martinclausen2/Nachttischlampe/mechanics/Beschreibung Mechanik LED Leuchte V2.odt

Beschreibung Mechanik Projekt LED Leuchte V2

Martin Clausen, Stand 2014-03-09

Übersicht zu bearbeitender mechanischer Bauteile für ein Pärchen (2 Stück).

Bauteil | Material | Bemerkung | Asymmetrie rechts/links | Anzahl
Arm | Item, 0.0.492.88, 480mm | | Orientierung zwischen Taschen und Ausfräsung | von 2 Varianten je ein Stück
Gelenk | Item, 0.0.601.13 | | Orientierung Bohrung | von 2 Varianten je ein Stück
beweglicher Arm | Item, 0.0.492.88, 160mm | | keine | 2 Stück
Fuß | Item, 0.0.493.04, 160mm | Gewindebohrungen im Raster 90mm x 21mm aus der Mitte verschoben angeordnet! | Orientierung der M8-Innengewinde | von 2 Varianten je ein Stück
Frontplatte | Aluminium-Blech, eloxiert natur | Stärke des Bleches kann 2mm oder 2,5mm sein | keine | 2 Stück
Kappe 40x80 | Item, 0.0.489.61 | | keine | 2 Stück
Kappe 80x80 | Item, 0.0.489.98 | | keine | 2 Stück

Alle Bauteile frei von Kratzern und Spänen, Aluminium makellos eloxiert (natur)
