martinclausen2/Nachttischlampe/mechanics/Lampe links.FCStd

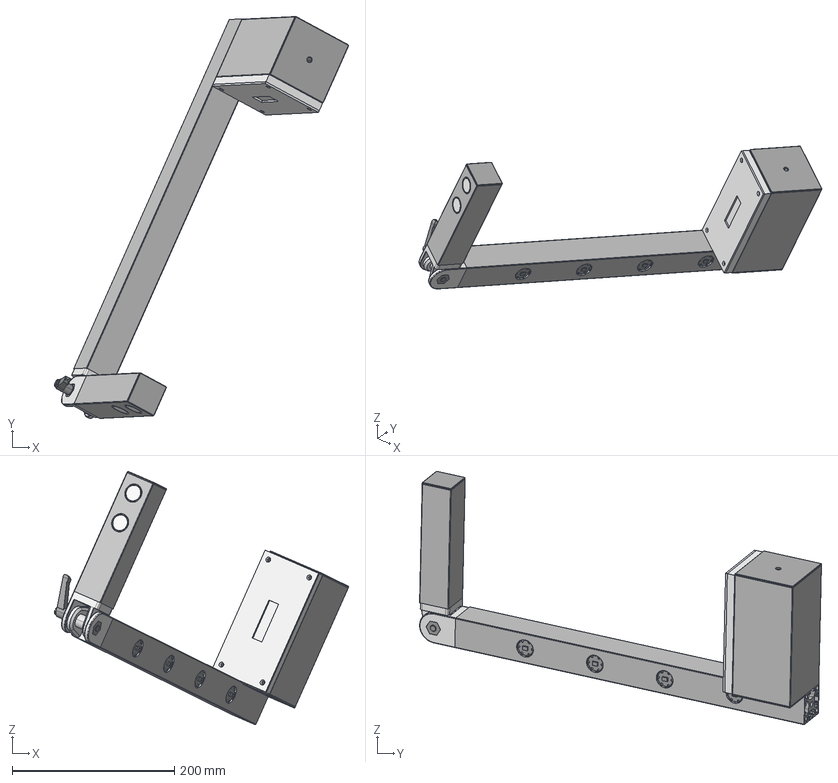
[picture p1: CAD file, 2016-03-12]
mechanics/Lampe links.FCStd
362.3 x 494.8 x 311.9 mm
Fuss links
Arm links
Kappe80x80
Kappe80x40
0.0.601.13_4 links
0.0.601.13_5 links
beweglicher_Arm
Kappe40x40
LED-Star
LED-Star001
LED-Star002
LED-Star003
LED-Star004
LED-Star005
LED Spacer
LED Spacer001
LED Spacer002
LED Spacer003
Linse
Linse001
Frontplattenspacer
Frontplatte
pcb
