martinclausen2/Nachttischlampe/mechanics/Lampe.FCStd

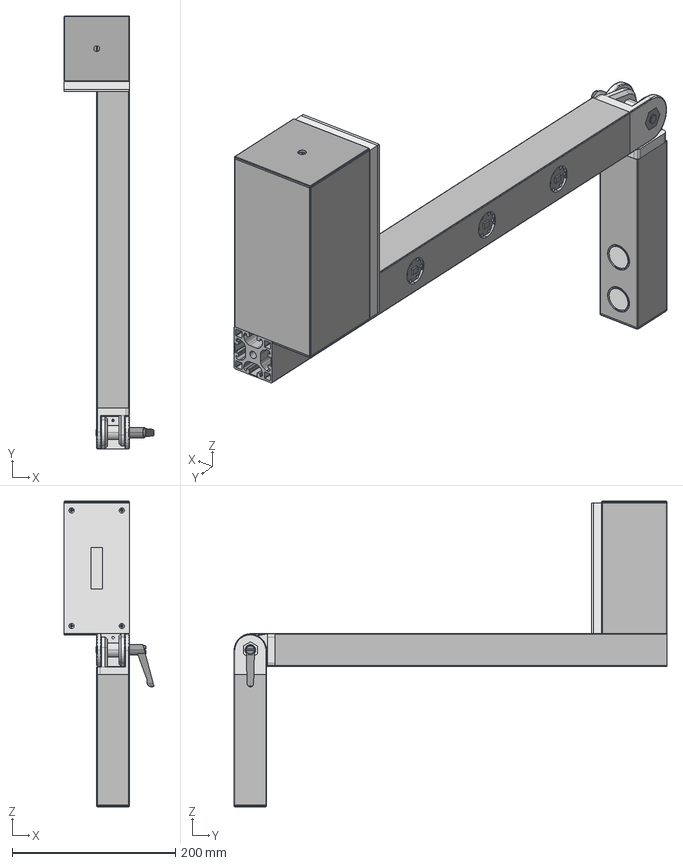
[picture p2: CAD file, 2016-03-12]
mechanics/Lampe.FCStd
110.1 x 530.0 x 374.0 mm
Fuss
Arm
Kappe80x80
Kappe80x40
beweglicher_Arm
Kappe40x40
LED-Star
LED-Star001
LED-Star002
LED-Star003
LED-Star004
LED-Star005
LED Spacer
LED Spacer001
LED Spacer002
LED Spacer003
Linse
Linse001
Frontplattenspacer
Frontplatte
pcb
