martinclausen2/Nachttischlampe/schematics/LED-Lampe Power  ZXLD1374.brd

## EAGLE design schematics/LED-Lampe Power ZXLD1374.brd

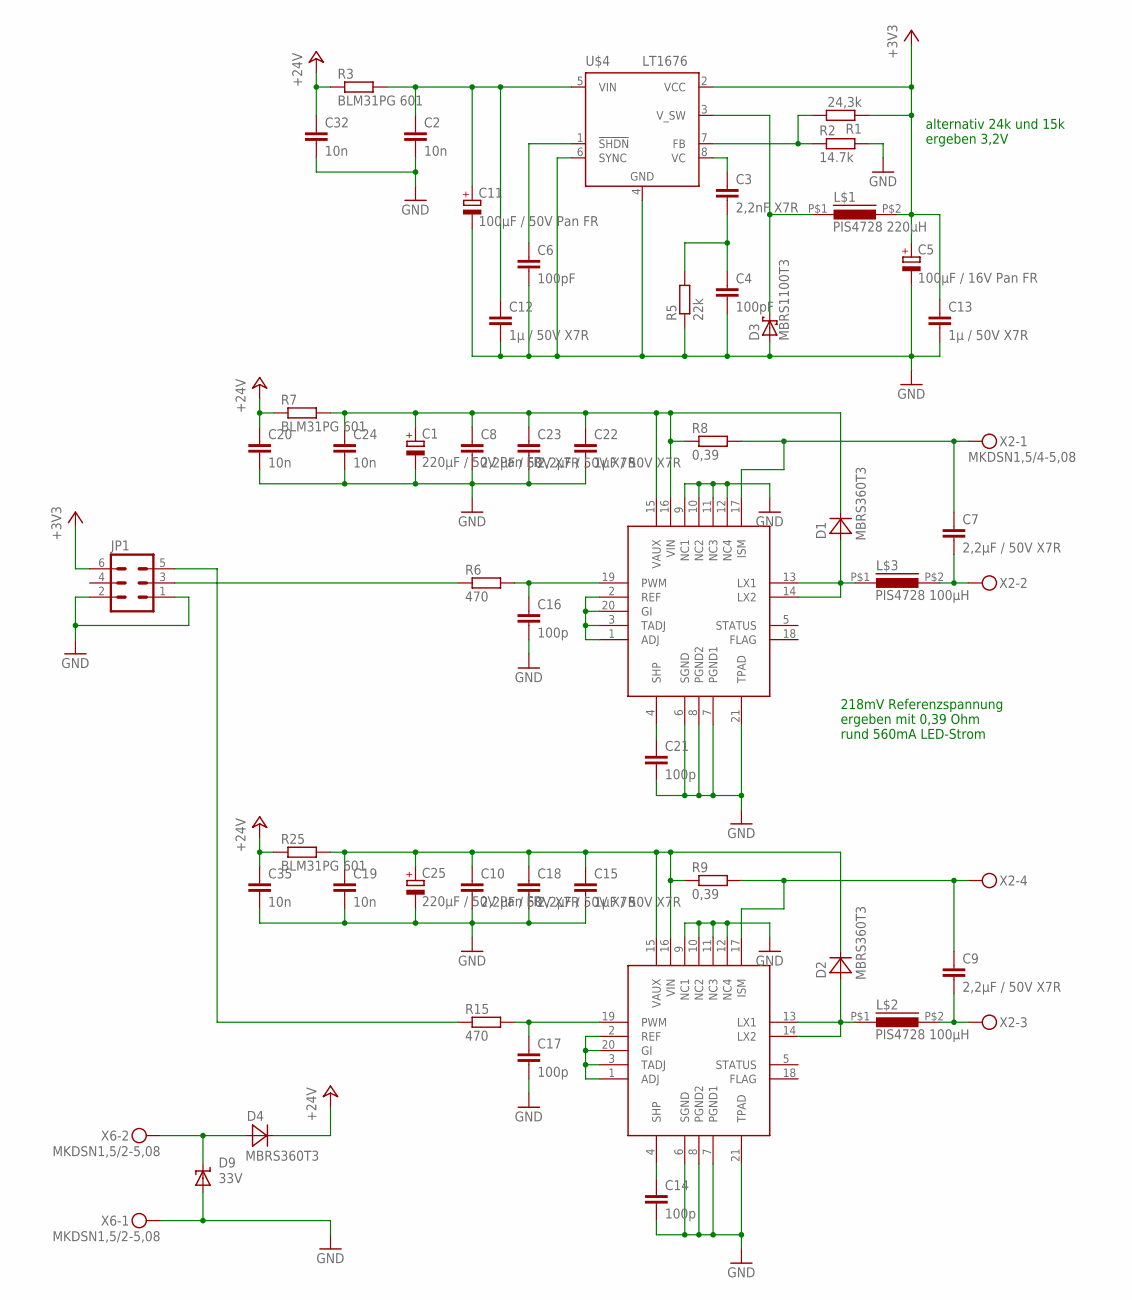
[picture p3: schematic LED-Lampe Power ZXLD1374.sch]

Parts:
C1, C25: 220µF / 50V Pan FR; E5-10,5
C2, C19, C20, C24, C32, C35: 10n; C0805
C3: 2,2nF X7R; C0603
C4, C6: 100pF; C0603
C5: 100µF / 16V Pan FR; E2-5
C7, C8, C9, C10, C18, C23: 2,2µF / 50V X7R; C1206
C11: 100µF / 50V Pan FR; E3,5-8
C12, C13: 1µ / 50V X7R; C1206
C14, C16, C17, C21: 100p; C0603
C15, C22: 1µF / 50V X7R; C1206
D1, D2, D4: MBRS360T3; SMC
D3: MBRS1100T3; SMB
D9: 33V; SMBJ
JP1: ML6
L$1: PIS4728 220µH; FASTON_PIS4728
L$2, L$3: PIS4728 100µH; FASTON_PIS4728
R1: 24,3k; R1206
R2: 14.7k; R1206
R3, R7, R25: BLM31PG 601; R1206
R5: 22k; R1206
R6, R15: 470; R0805
R8, R9: 0,39; R1206
U$4: LT1676; S8
U$5, U$6: ZXLD1374; TSSOP20
X2: MKDSN1,5/4-5,08
X6: MKDSN1,5/2-5,08

Connections:
+3V3: C5.+, C13.1, JP1.6, L$1.P$2 (2), R1.1, U$4.2 (VCC)
+24V: C20.1, C32.1, C35.1, D4.C, R3.1, R7.1, R25.1
GND: C1.-, C2.2, C4.2, C5.-, C6.2, C8.2, C10.2, C11.-, C12.2, C13.2, C14.2, C15.2, C16.2, C17.2, C18.2, C19.2, C20.2, C21.2, C22.2, C23.2, C24.2, C25.-, C32.2, C35.2, D3.A, D9.A, JP1.1, JP1.2, R2.2, R5.1, U$4.4 (GND), U$4.6 (SYNC), U$5.6 (SGND), U$5.7 (PGND1), U$5.8 (PGND2), U$5.9 (NC1), U$5.10 (NC2), U$5.11 (NC3), U$5.12 (NC4), U$5.21 (TPAD), U$6.6 (SGND), U$6.7 (PGND1), U$6.8 (PGND2), U$6.9 (NC1), U$6.10 (NC2), U$6.11 (NC3), U$6.12 (NC4), U$6.21 (TPAD), X6.1
unnamed: C2.1, C11.+, C12.1, R3.2, U$4.5 (VIN)
unnamed: U$5.1 (ADJ), U$5.2 (REF), U$5.3 (TADJ), U$5.20 (GI)
unnamed: C3.2, C4.1, R5.2
unnamed: R1.2, R2.1, U$4.7 (FB)
unnamed: D3.C, L$1.P$1 (1), U$4.3 (V_SW)
unnamed: JP1.3, R6.1
unnamed: C1.+, C8.1, C22.1, C23.1, C24.1, D1.C, R7.2, R8.1, U$6.15 (VAUX), U$6.16 (VIN)
unnamed: D4.A, D9.C, X6.2
unnamed: C3.1, U$4.8 (VC)
unnamed: C9.2, L$2.P$2 (2), X2.3
unnamed: C17.1, R15.2, U$5.19 (PWM)
unnamed: C6.1, U$4.1 (!SHDN)
unnamed: C9.1, R9.2, U$5.17 (ISM), X2.4
unnamed: C14.1, U$5.4 (SHP)
unnamed: D2.A, L$2.P$1 (1), U$5.13 (LX1), U$5.14 (LX2)
unnamed: C16.1, R6.2, U$6.19 (PWM)
unnamed: C7.2, L$3.P$2 (2), X2.2
unnamed: C7.1, R8.2, U$6.17 (ISM), X2.1
unnamed: U$6.1 (ADJ), U$6.2 (REF), U$6.3 (TADJ), U$6.20 (GI)
unnamed: C21.1, U$6.4 (SHP)
unnamed: D1.A, L$3.P$1 (1), U$6.13 (LX1), U$6.14 (LX2)
unnamed: C10.1, C15.1, C18.1, C19.1, C25.+, D2.C, R9.1, R25.2, U$5.15 (VAUX), U$5.16 (VIN)
P1.6: JP1.5, R15.1

Notes on the sheet:
218mV Referenzspannung ergeben mit 0,39 Ohm rund 560mA LED-Strom
alternativ 24k und 15k ergeben 3,2V

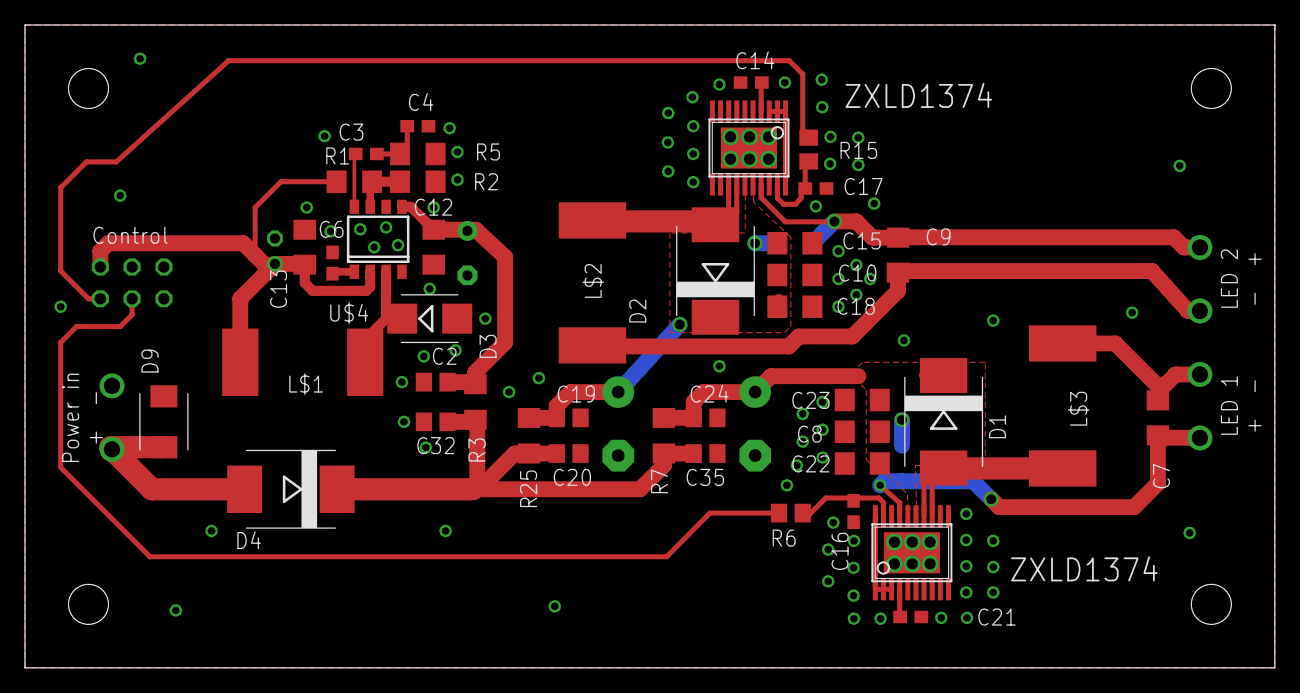
[picture p4: board LED-Lampe Power ZXLD1374.brd from above]

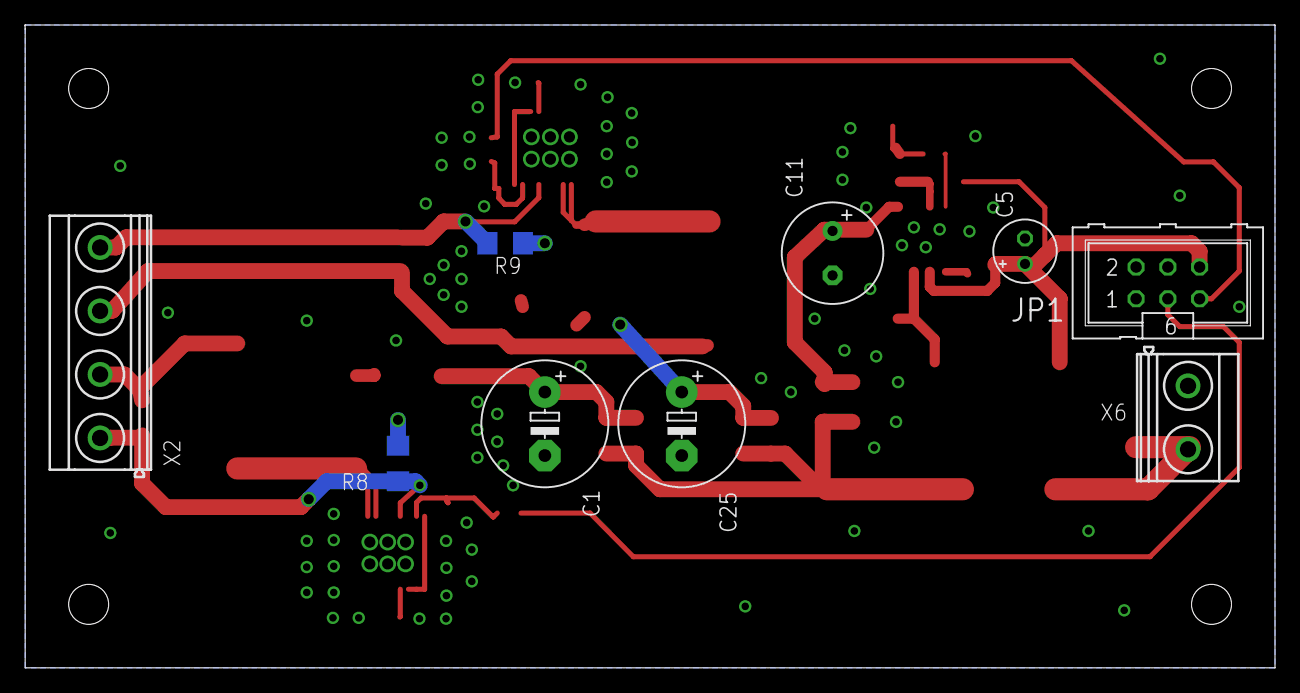
[picture p5: board LED-Lampe Power ZXLD1374.brd from below]

Board: 2 copper layers, 100.0 x 51.4 mm, 51 parts (9 on the bottom side), 26 nets.
