martinclausen2/Nachttischlampe/schematics/LED-Lampe MCU.brd

## EAGLE design schematics/LED-Lampe MCU.brd (2016-03-12)

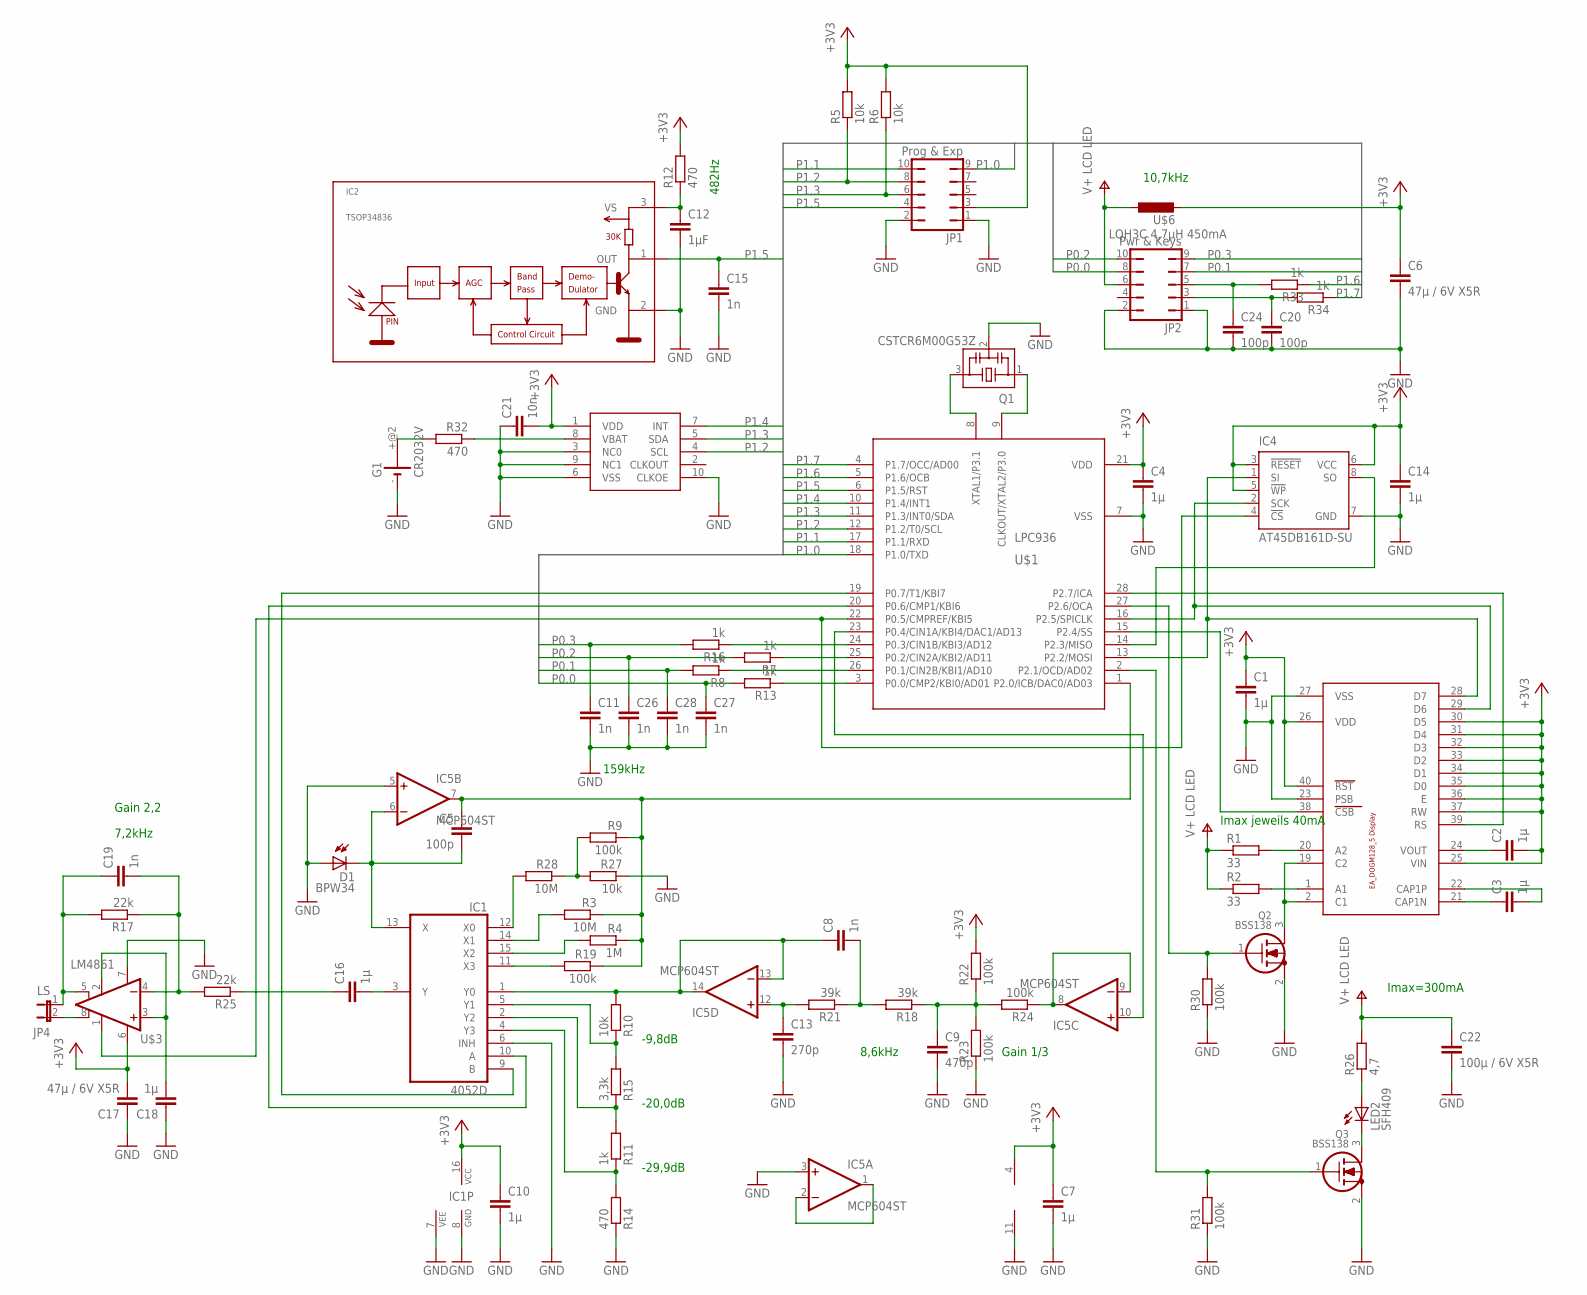
[picture p6: schematic LED-Lampe MCU.sch]

Parts:
C1, C2, C3, C4, C7, C10, C14: 1µ; C0805
C5, C20, C24: 100p; C0603
C6, C17: 47µ / 6V X5R; C1206
C8, C19: 1n; C0805
C9: 470p; C0805
C11, C15, C26, C27, C28: 1n; C0603
C12: 1µF; C0805
C13: 270p; C0805
C16, C18: 1µ; C1206
C21: 10n; C0805
C22: 100µ / 6V X5R; C1206
D1: BPW34; BPW32
G1: CR2032V
IC1: 4052D; SO16
IC2: TSOP34836; TSOP348
IC4: AT45DB161D-SU; 8S2
IC5: MCP604ST; TSSOP14
JP1: Prog & Exp; JP5Q
JP2: Pwr & Keys; JP5Q
JP4: LS; JP1
LED2: SFH409; LED3MM
Q1: CSTCR6M00G53Z; CSTCR6M
Q2, Q3: BSS138; SOT23
R1, R2: 33; R1206
R3, R28: 10M; R0805
R4: 1M; R0805
R5, R6, R10, R27: 10k; R0805
R7, R8, R11, R13, R16, R33, R34: 1k; R0805
R9, R19, R22, R23, R24, R30, R31: 100k; R0805
R12, R14, R32: 470; R0805
R15: 3,3k; R0805
R17, R25: 22k; R0805
R18, R21: 39k; R0805
R26: 4,7; R1206
U$1: LPC936; TSSOP28
U$2: EA_DOGM162; E_DOG-M162
U$3: LM4861; SO08
U$4: RV3029-C2; MC_RTC
U$6: LQH3C 4,7µH 450mA; L1210

Connections:
+3V3: C1.1, C2.2, C4.1, C6.1, C7.1, C10.1, C14.1, C17.2, C21.2, IC1.16 (VCC), IC4.3 (!RESET), IC4.5 (!WP), IC4.6 (VCC), IC5.4 (V+), JP1.3, R5.2, R6.2, R12.2, R22.2, U$1.21 (VDD), U$2.25 (VIN), U$2.26 (VDD), U$2.30 (D5), U$2.31 (D4), U$2.32 (D3), U$2.33 (D2), U$2.34 (D1), U$2.35 (D0), U$2.36 (E), U$2.37 (RW), U$2.40 (RST), U$3.6 (VDD), U$4.1 (VDD), U$6.2
GND: C1.2, C4.2, C6.2, C7.2, C9.2, C10.2, C11.2, C12.2, C13.2, C14.2, C15.2, C17.1, C18.1, C20.2, C21.1, C22.2, C24.2, C26.2, C27.2, C28.2, D1.A, G1.-, IC1.6 (INH), IC1.7 (VEE), IC1.8 (GND), IC2.2 (GND), IC4.7 (GND), IC5.3 (+IN), IC5.5 (+IN), IC5.11 (V-), JP1.1, JP1.2, JP2.1, JP2.2, Q1.2, Q2.2 (S), Q3.2 (S), R14.1, R23.1, R27.1, R30.1, R31.1, U$1.7 (VSS), U$2.23 (PSB), U$2.27 (VSS), U$3.7 (GND), U$4.3 (NC0), U$4.6 (VSS), U$4.9 (NC1), U$4.10 (CLKOE)
unnamed: C2.1, U$2.24 (VOUT)
unnamed: IC1.9 (B), U$1.19 (P0.7/T1/KBI7)
unnamed: C3.2, U$2.22 (CAP1P)
unnamed: C3.1, U$2.21 (CAP1N)
unnamed: U$1.15 (P2.4/SS), U$2.38 (CSB)
unnamed: C12.1, IC2.3 (VS), R12.1
unnamed: R1.2, U$2.20 (A2)
unnamed: R2.2, U$2.1 (A1)
unnamed: IC4.2 (SCK), U$1.16 (P2.5/SPICLK), U$2.29 (D6)
unnamed: IC4.1 (SI), U$1.13 (P2.2/MOSI), U$2.28 (D7)
unnamed: Q2.1 (G), R30.2, U$1.27 (P2.6/OCA)
unnamed: IC1.10 (A), U$1.20 (P0.6/CMP1/KBI6)
unnamed: U$1.28 (P2.7/ICA), U$2.39 (RS)
unnamed: Q1.3, U$1.8 (XTAL1/P3.1)
unnamed: Q1.1, U$1.9 (CLKOUT/XTAL2/P3.0)
unnamed: Q2.3 (D), U$2.2 (C1), U$2.19 (C2)
unnamed: R8.1, U$1.26 (P0.1/CIN2B/KBI1/AD10)
unnamed: JP4.2, U$3.8 (VO2)
unnamed: R16.1, U$1.24 (P0.3/CIN1B/KBI3/AD12)
unnamed: R13.1, U$1.3 (P0.0/CMP2/KBI0/AD01)
unnamed: C18.2, U$3.2 (BYPASS), U$3.3 (+IN)
unnamed: R7.1, U$1.25 (P0.2/CIN2A/KBI2/AD11)
unnamed: IC4.8 (SO), U$1.14 (P2.3/MISO)
unnamed: IC1.4 (Y3), R11.1, R14.2
unnamed: IC1.2 (Y2), R11.2, R15.1
unnamed: IC1.5 (Y1), R10.1, R15.2
unnamed: C8.1, IC1.1 (Y0), IC5.13 (-IN), IC5.14 (OUT), R10.2
unnamed: C13.1, IC5.12 (+IN), R21.2
unnamed: C8.2, R18.2, R21.1
unnamed: LED2.A, R26.1
unnamed: IC5.10 (+IN), U$1.23 (P0.4/CIN1A/KBI4/DAC1/AD13)
unnamed: C5.2, D1.K (C), IC1.13 (X), IC5.6 (-IN)
unnamed: C5.1, IC5.7 (OUT), R3.1, R4.1, R9.1, R19.1, U$1.1 (P2.0/ICB/DAC0/AD03)
unnamed: IC1.11 (X3), R19.2
unnamed: C9.1, R18.1, R22.1, R23.2, R24.2
unnamed: Q3.1 (G), R31.2, U$1.2 (P2.1/OCD/AD02)
unnamed: IC1.15 (X2), R4.2
unnamed: IC1.14 (X1), R3.2
unnamed: IC1.12 (X0), R28.2
unnamed: C19.2, R17.1, R25.2, U$3.4 (-IN)
unnamed: C16.1, R25.1
unnamed: C16.2, IC1.3 (Y)
unnamed: C19.1, JP4.1, R17.2, U$3.5 (VO1)
unnamed: LED2.K (C), Q3.3 (D)
unnamed: IC4.4 (!CS), U$1.22 (P0.5/CMPREF/KBI5), U$3.1 (SHUTDOWN)
unnamed: R32.1, U$4.8 (VBAT)
unnamed: R9.2, R27.2, R28.1
unnamed: IC5.8 (OUT), IC5.9 (-IN), R24.1
unnamed: G1.+@2 (+), R32.2
unnamed: IC5.1 (OUT), IC5.2 (-IN)
unnamed: C24.1, JP2.5, R33.2
unnamed: C20.1, JP2.3, R34.2
P0.0: C27.1, JP2.8, R13.2
P0.1: C28.1, JP2.7, R8.2
P0.2: C26.1, JP2.10, R7.2
P0.3: C11.1, JP2.9, R16.2
P1.0: JP1.9, U$1.18 (P1.0/TXD)
P1.1: JP1.10, U$1.17 (P1.1/RXD)
P1.2: JP1.8, R5.1, U$1.12 (P1.2/T0/SCL), U$4.4 (SCL)
P1.3: JP1.6, R6.1, U$1.11 (P1.3/INT0/SDA), U$4.5 (SDA)
P1.4: U$1.10 (P1.4/INT1), U$4.7 (INT)
P1.5: C15.1, IC2.1 (OUT), JP1.4, U$1.6 (P1.5/RST)
P1.6: R33.1, U$1.5 (P1.6/OCB)
P1.7: R34.1, U$1.4 (P1.7/OCC/AD00)
V+: C22.1, JP2.6, R1.1, R2.1, R26.2, U$6.1

Notes on the sheet:
10,7kHz
482Hz
159kHz
8,6kHz
Gain 1/3
Gain 2,2
7,2kHz
Imax=300mA
-9,8dB
-20,0dB
-29,9dB
Imax jeweils 40mA

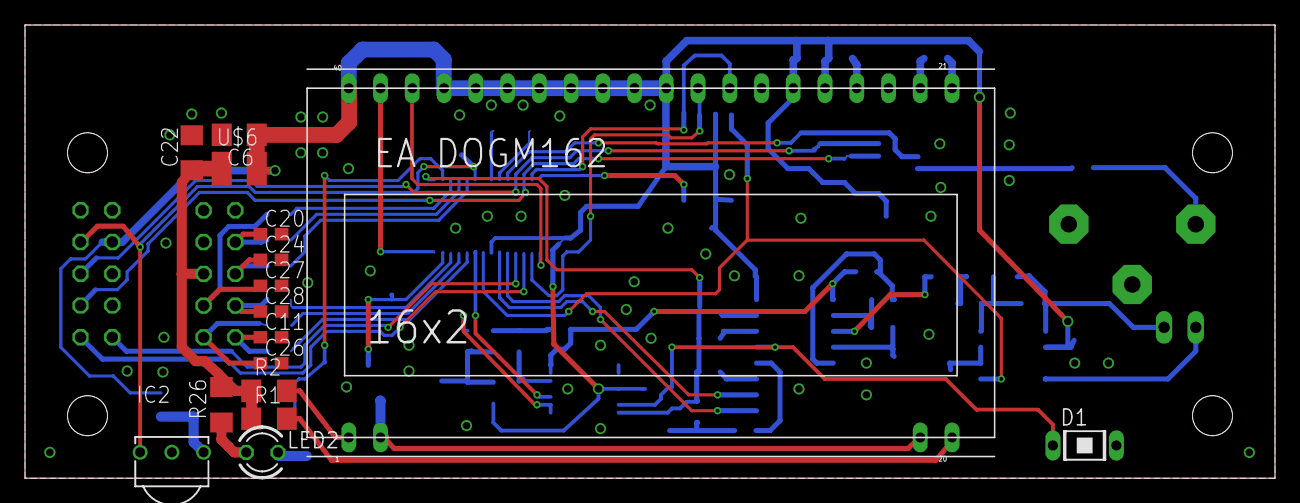
[picture p7: board LED-Lampe MCU.brd from above]

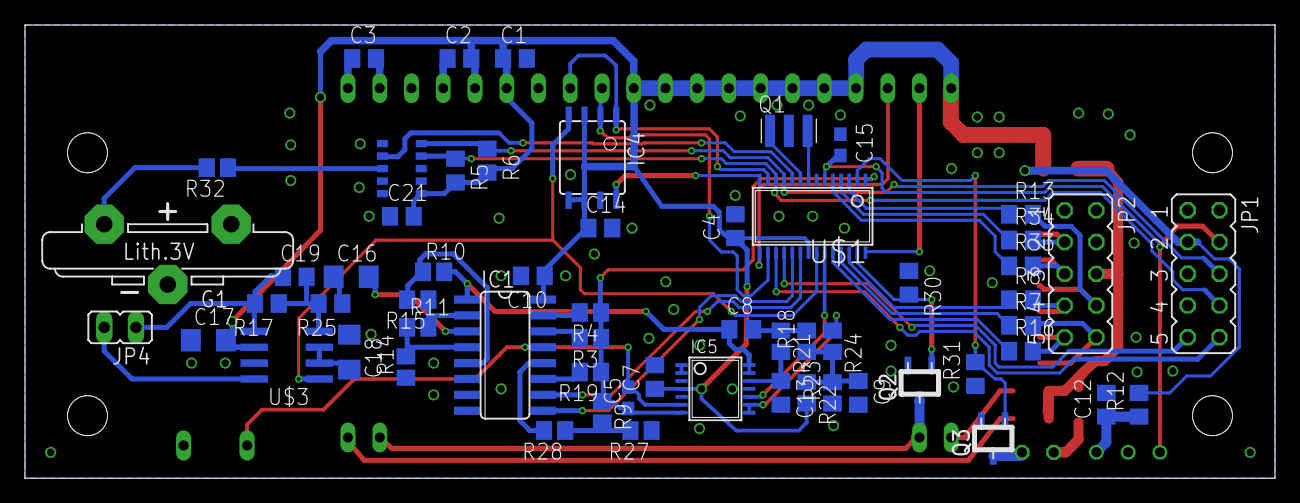
[picture p8: board LED-Lampe MCU.brd from below]

Board: 2 copper layers, 100.0 x 36.3 mm, 76 parts (60 on the bottom side), 67 nets.
