martinclausen2/Nachttischlampe/schematics/LED-Lampe Power  ZXLD1374.brd

## EAGLE design schematics/LED-Lampe Power ZXLD1362.brd

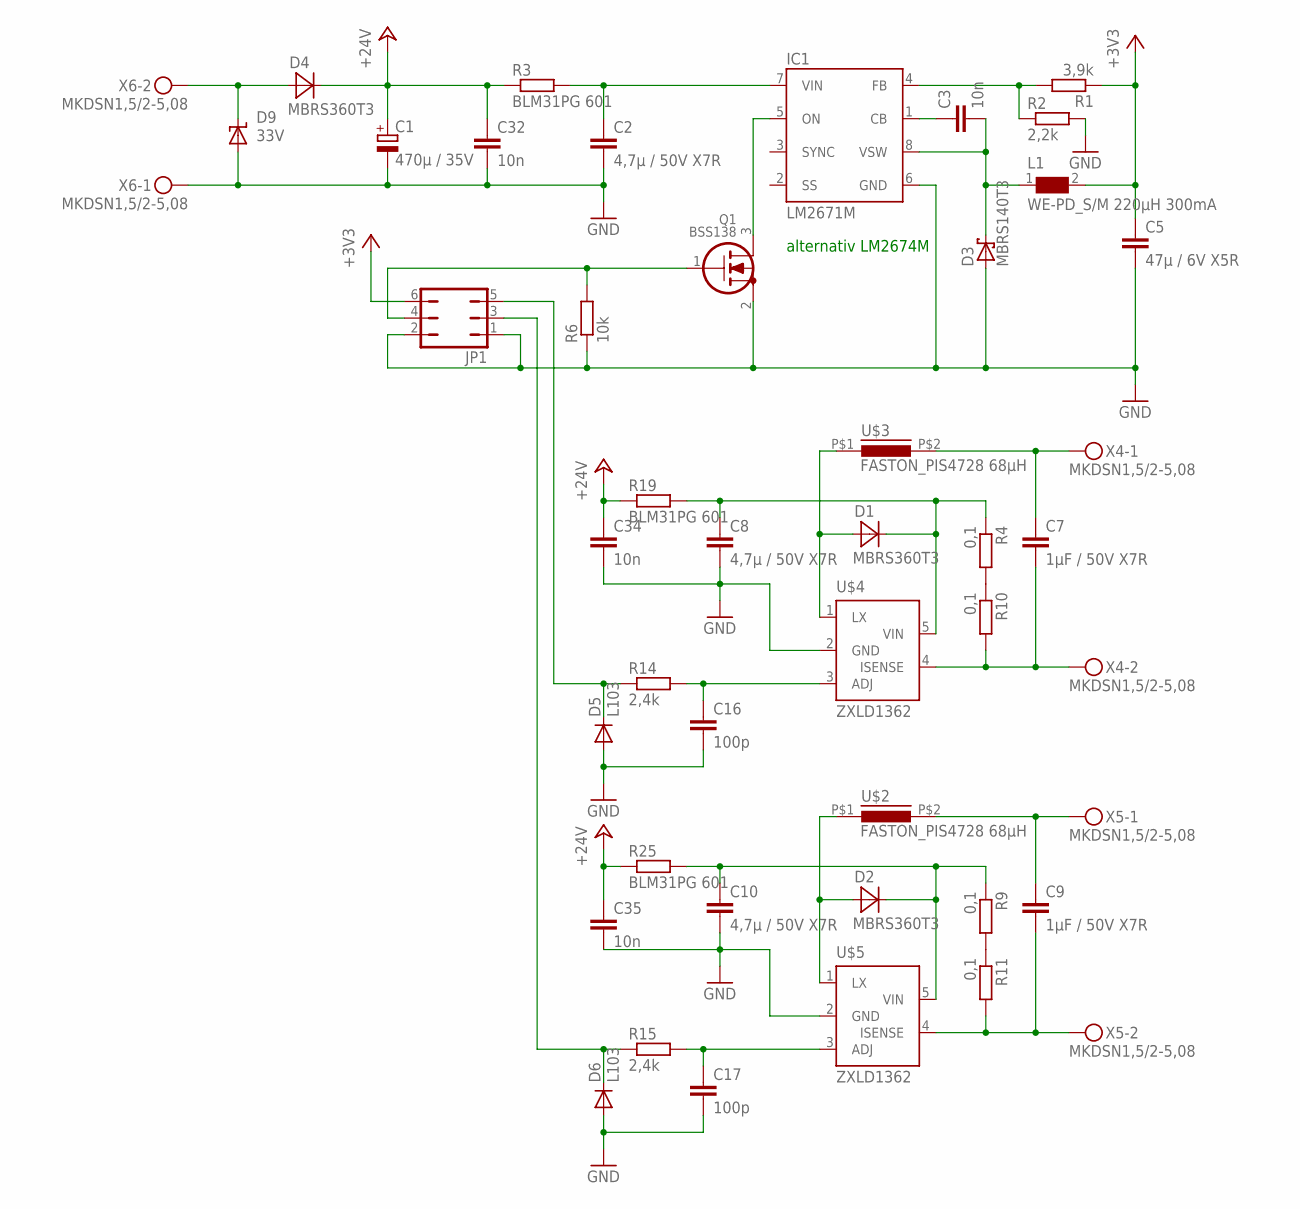
[picture p9: schematic LED-Lampe Power ZXLD1362.sch]

Parts:
C1: 470µ / 35V; E5-13
C2, C8, C10: 4,7µ / 50V X7R; C1206
C3, C32, C34, C35: 10n; C1206
C5: 47µ / 6V X5R; C1206
C7, C9: 1µF / 50V X7R; C1206
C16, C17: 100p; C0603
D1, D2, D4: MBRS360T3; SMC
D3: MBRS140T3; SMB
D5, D6: L103; SOD123
D9: 33V; SMBJ
IC1: LM2671M; SO08
JP1: JP3Q
L1: WE-PD_S/M 220µH 300mA; WE-PD_S/M
Q1: BSS138; SOT23
R1: 3,9k; R1206
R2: 2,2k; R1206
R3, R19, R25: BLM31PG 601; R1206@1
R4, R9, R10, R11: 0,1; R1206@1
R6: 10k; R1206
R14, R15: 2,4k; R1206
U$2, U$3: FASTON_PIS4728 68µH; FASTON_PIS4728
U$4, U$5: ZXLD1362; SOT23-5
X4, X5, X6: MKDSN1,5/2-5,08

Connections:
+3V3: C5.1, JP1.6, L1.2, R1.1
+24V: C1.+, C32.1, C34.1, C35.1, D4.C, R3.1, R19.1, R25.1
GND: C1.-, C2.2, C5.2, C8.2, C10.2, C16.2, C17.2, C32.2, C34.2, C35.2, D3.A, D5.A, D6.A, D9.A, IC1.6 (GND), JP1.1, JP1.2, Q1.2 (S), R2.2, R6.1, U$4.2 (GND), U$5.2 (GND), X6.1
unnamed: C2.1, IC1.7 (VIN), R3.2
unnamed: C3.1, IC1.1 (CB)
unnamed: IC1.4 (FB), R1.2, R2.1
unnamed: C3.2, D3.C, IC1.8 (VSW), L1.1
unnamed: JP1.4, Q1.1 (G), R6.2
unnamed: R4.2, R10.1
unnamed: R9.2, R11.1
unnamed: D4.A, D9.C, X6.2
unnamed: C16.1, R14.2, U$4.3 (ADJ)
unnamed: IC1.5 (ON), Q1.3 (D)
unnamed: C17.1, R15.2, U$5.3 (ADJ)
unnamed: D1.A, U$3.P$1 (1), U$4.1 (LX)
unnamed: C7.1, U$3.P$2 (2), X4.1
unnamed: C7.2, R10.2, U$4.4 (ISENSE), X4.2
unnamed: D2.A, U$2.P$1 (1), U$5.1 (LX)
unnamed: C9.1, U$2.P$2 (2), X5.1
unnamed: C9.2, R11.2, U$5.4 (ISENSE), X5.2
unnamed: C8.1, D1.C, R4.1, R19.2, U$4.5 (VIN)
unnamed: C10.1, D2.C, R9.1, R25.2, U$5.5 (VIN)
P1.6: D6.C, JP1.3, R15.1
P1.7: D5.C, JP1.5, R14.1

Notes on the sheet:
alternativ LM2674M

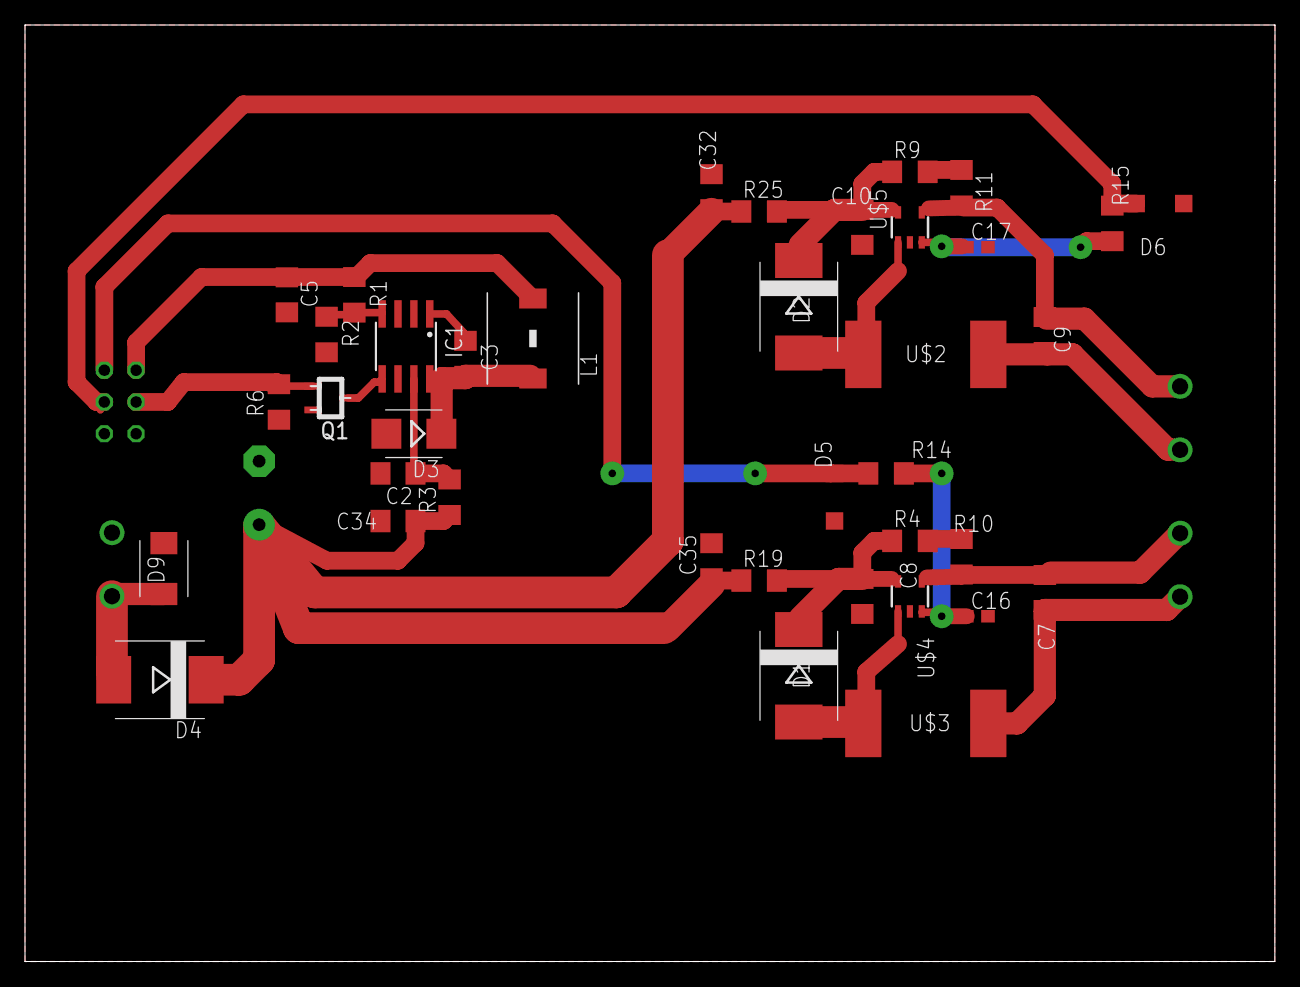
[picture p10: board LED-Lampe Power ZXLD1362.brd from above]

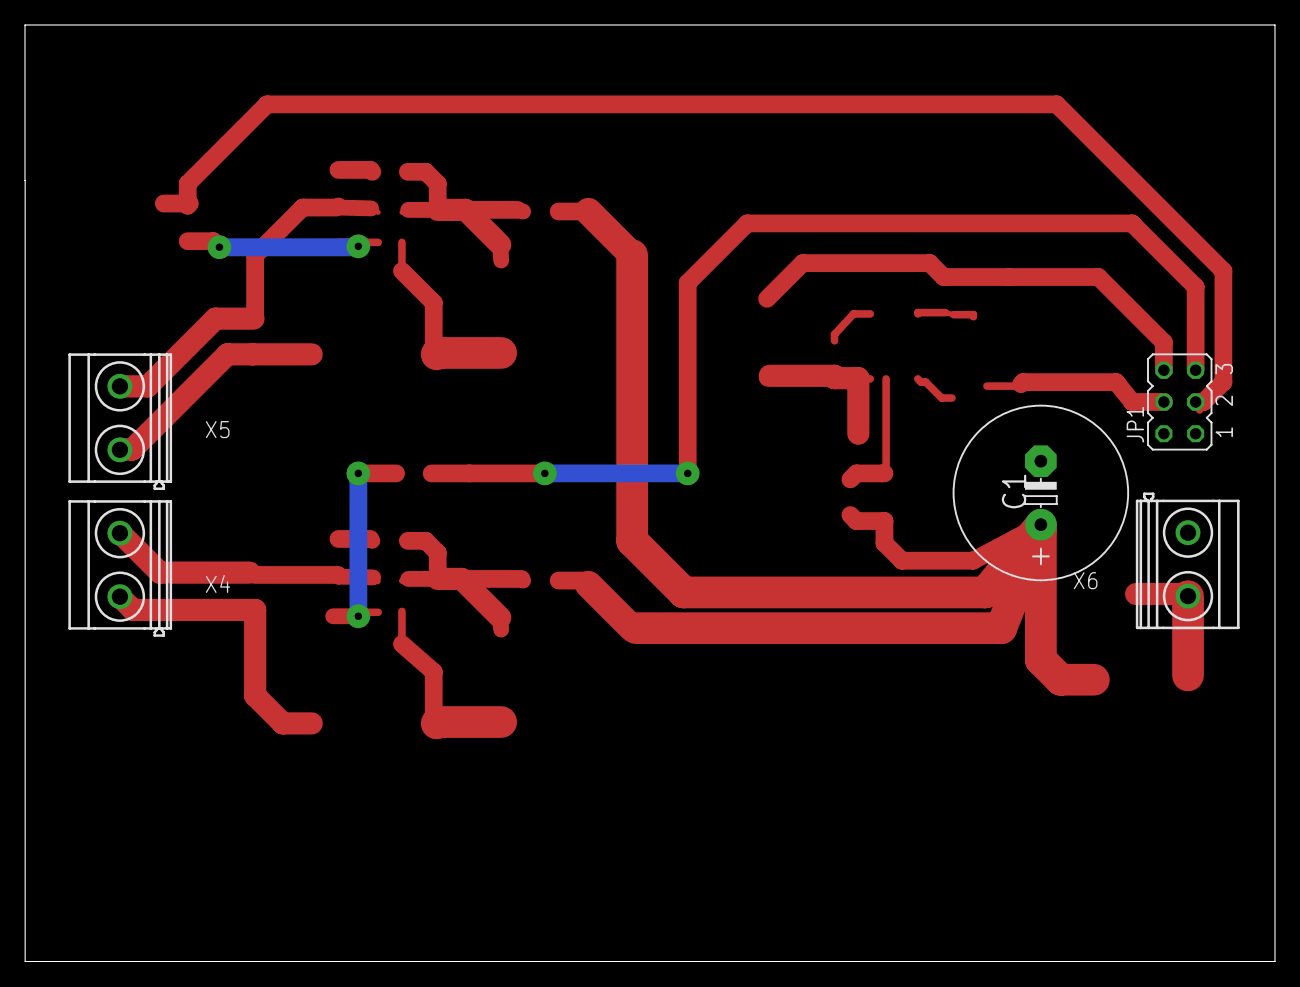
[picture p11: board LED-Lampe Power ZXLD1362.brd from below]

Board: 2 copper layers, 100.0 x 74.9 mm, 43 parts (5 on the bottom side), 24 nets.
