martinclausen2/Nachttischlampe/sinetable.c

__code unsigned char sinetable [] = 
{
128	,
131	,
134	,
137	,
140	,
143	,
146	,
149	,
152	,
156	,
159	,
162	,
165	,
168	,
171	,
174	,
176	,
179	,
182	,
185	,
188	,
191	,
193	,
196	,
199	,
201	,
204	,
206	,
209	,
211	,
213	,
216	,
218	,
220	,
222	,
224	,
226	,
228	,
230	,
232	,
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
};
