martinclausen2/Nachttischlampe/(commit log)

2013-10-11 Initial Upload
    [sinewave.ods]
2013-10-11 added schematics and PCB added mechanics
2013-11-03 - added dynamic PWM frequency selection - extended options menu by brightness offset and min brightness - increased dimming frequency to 40Hz
2013-12-09 - added fill & 2nd line function to lcd driver => code clean-up - added user feedback on key pressed - fixed missing pause between IR commands in all go standby - added fade in to snooze end menu - p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
    [LCD_EA_DOG_SPI.c, LCD_EA_DOG_SPI.h, Main.c, Options.c, Options.h, SetBrightness.c]
2014-02-03 - add: option to cancel key press - add: optional acoustic signal to acknowledge key press - add: ZXLD1374 support via compiler switch
2014-02-05 -fix: missing key acknowledge
    [Options.c]
2014-02-22 - changed to LED driver ZXLD1374 as a default - fixed output configuration of PWM Pins - added "sample beep" during beep volume adjustment, fixed volume enumeration
    [AcusticAlarm.c, InitMCU.c, Main.c, Options.c, Options.h]
2014-09-07 fix spelling fix time out for acoustic alarm
    [AcousticAlarm.c, Main.c]
2014-09-14 added time slots for main loop fixed timing other small fixes
    [AcousticAlarm.c, I2C_RTC.c, InitMCU.c, Main.c, Options.c, Options.h, RC5.c, SetBrightness.c]
2016-03-12 add mechanics and schematics
    [LED-Lampe MCU.brd, LED-Lampe MCU.sch, LED-Lampe Power ZXLD1362.brd, LED-Lampe Power ZXLD1362.sch, LED-Lampe Power ZXLD1374.brd, LED-Lampe Power ZXLD1374.sch, Lampe links.FCStd, Lampe.FCStd]
2021-03-28 adjust ADC settings for more precise ambient light measurement
