martinclausen2/Nachttischlampe/(notices)

Notices in the files:
parts and their libraries:
wuerth_elektronik_eisos__v6.8_20100429: Copyright: Würth Elektronik
